echoz/Perch/docs/base.webp

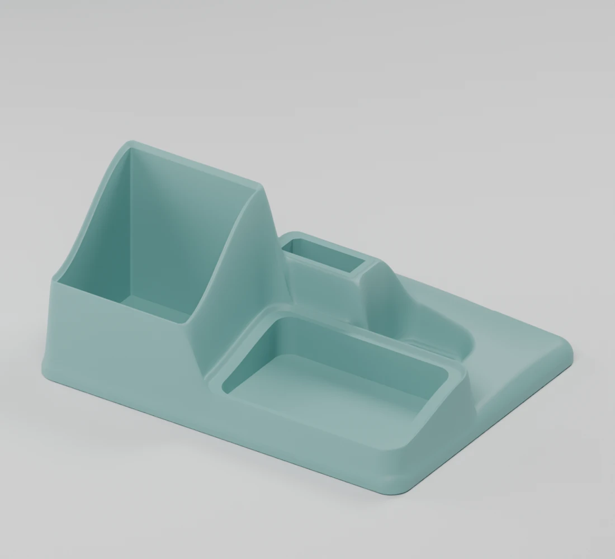
docs/base.webp
