echoz/Perch/docs/dock.webp

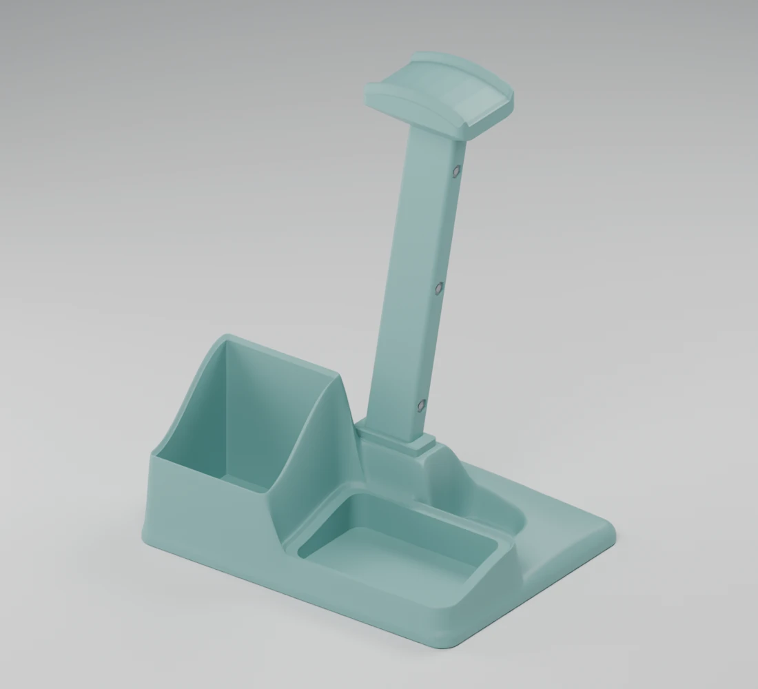
docs/dock.webp
