echoz/Perch/docs/loaded.webp

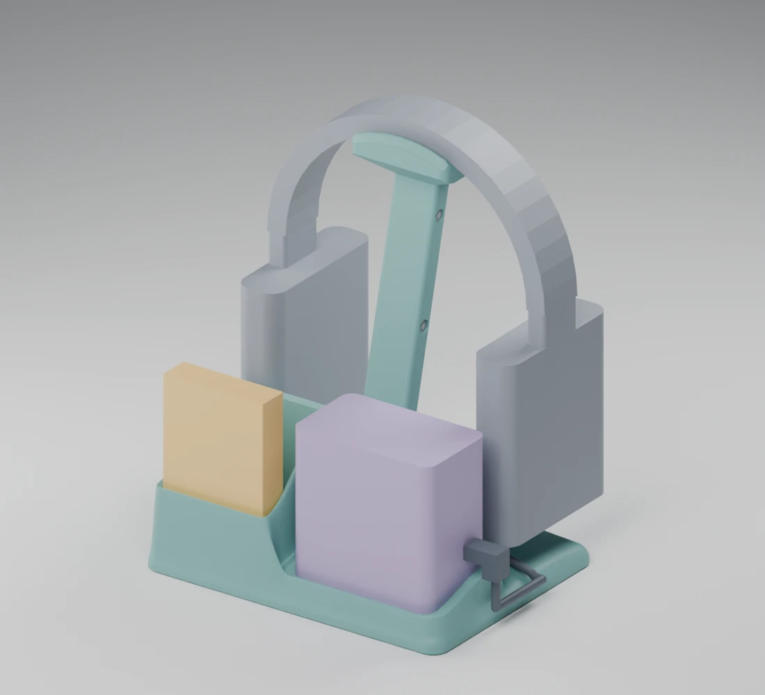
docs/loaded.webp
