echoz/Perch/docs/mast.webp

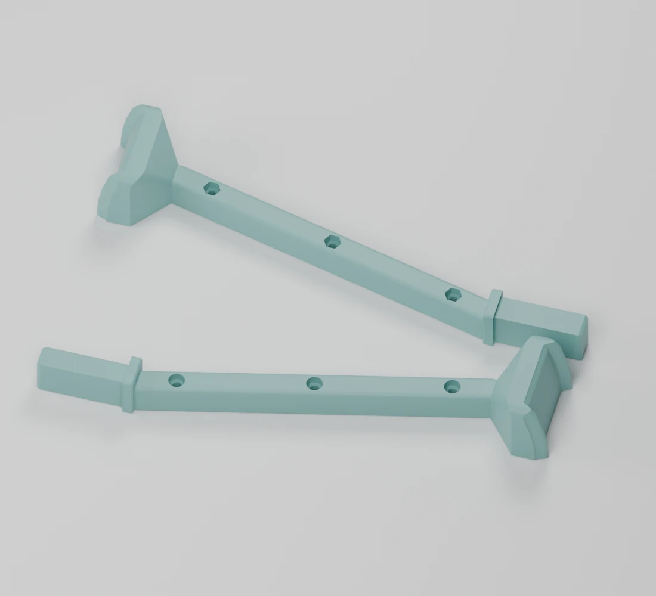
docs/mast.webp
