echoz/Perch/docs/rear.webp

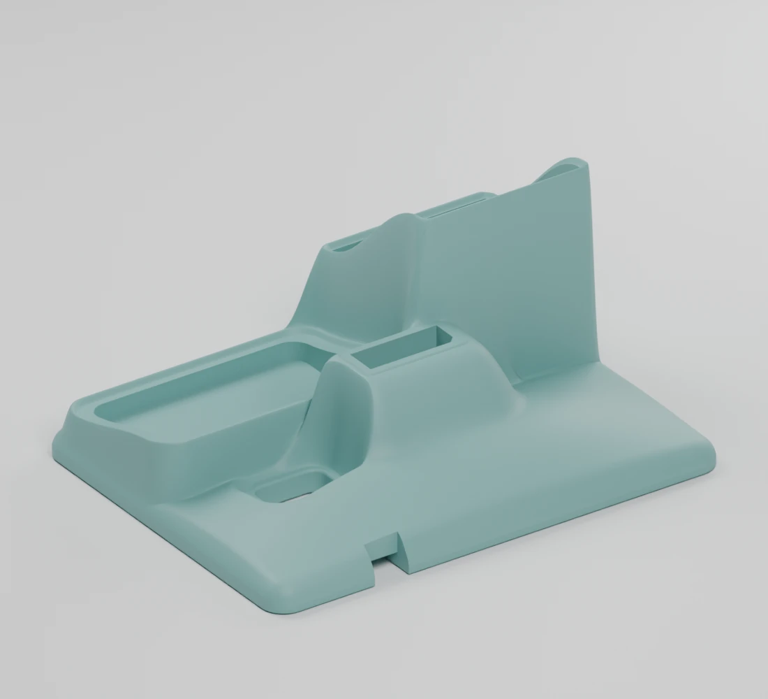
docs/rear.webp
