echoz/Perch/previews/base-cable-route.png

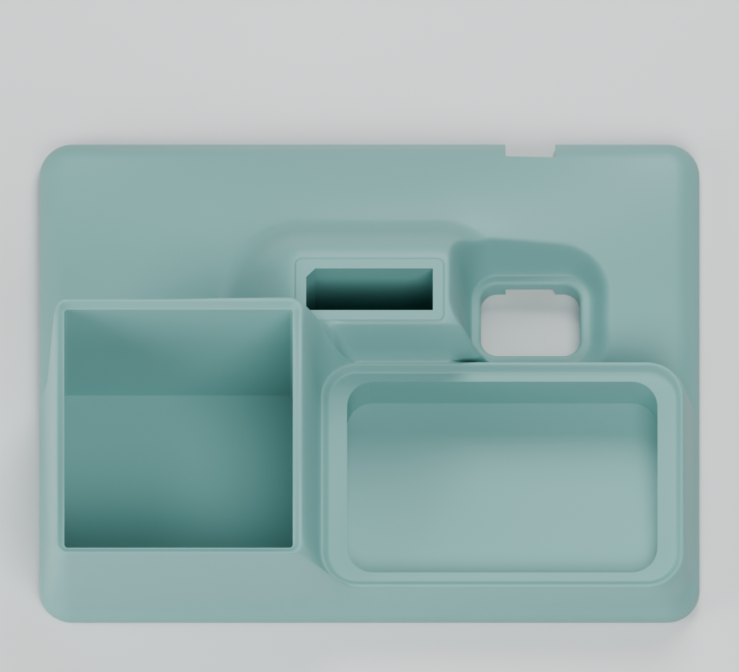
previews/base-cable-route.png
