echoz/Perch/previews/base-rear.png

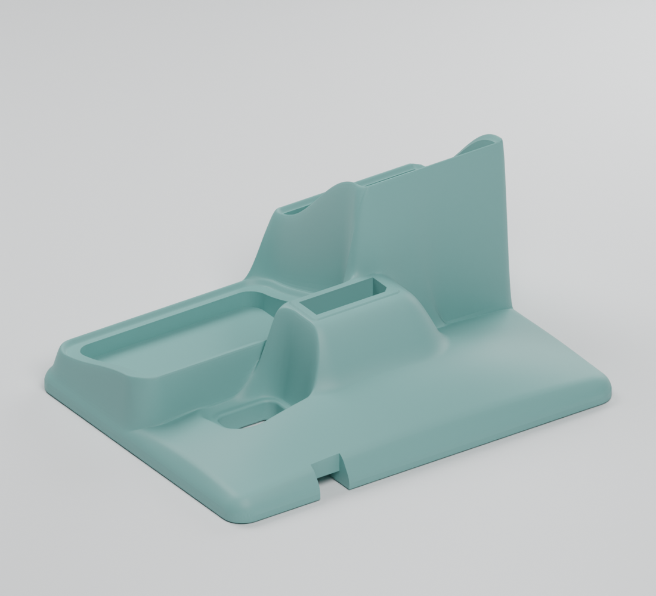
previews/base-rear.png
