echoz/Perch/previews/saddle-detail.png

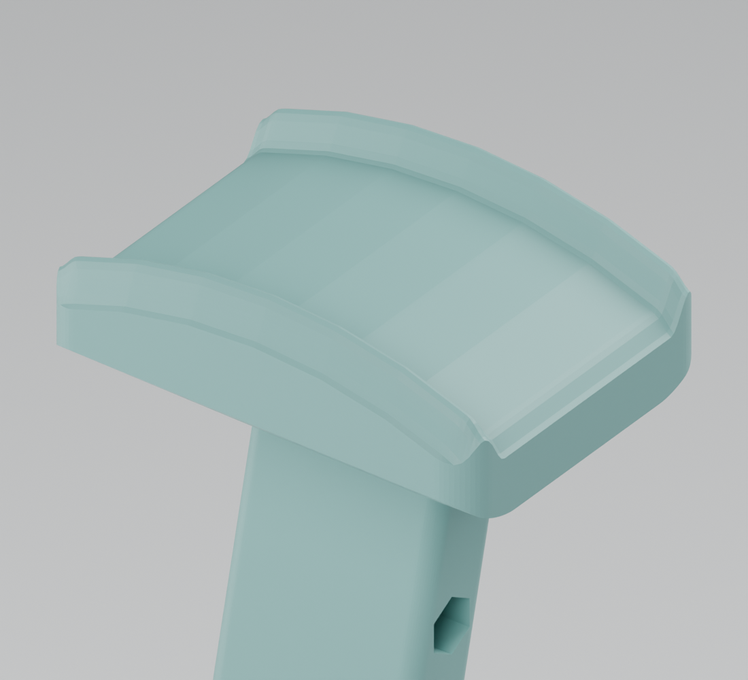
previews/saddle-detail.png
