echoz/Perch/previews/mast-print-layout.png

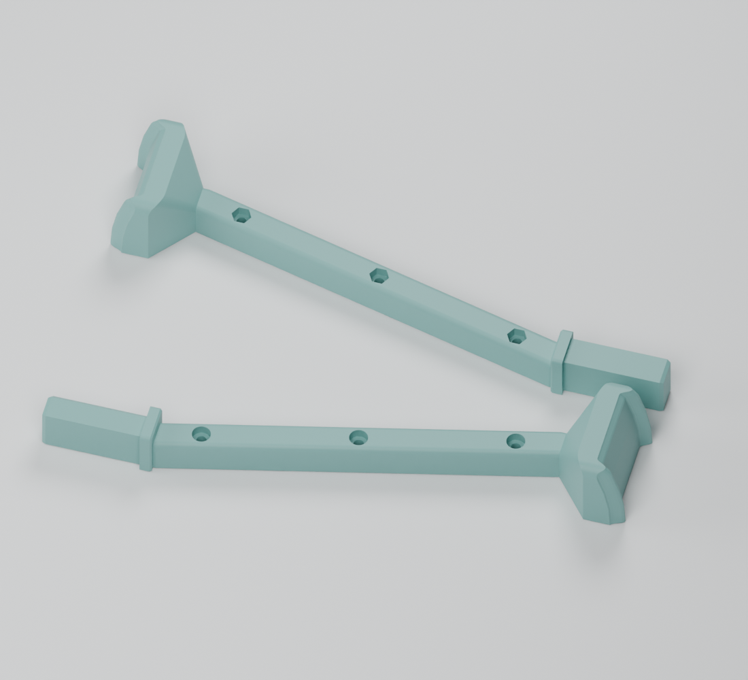
previews/mast-print-layout.png
