echoz/Perch/previews/mast-joint-test.png

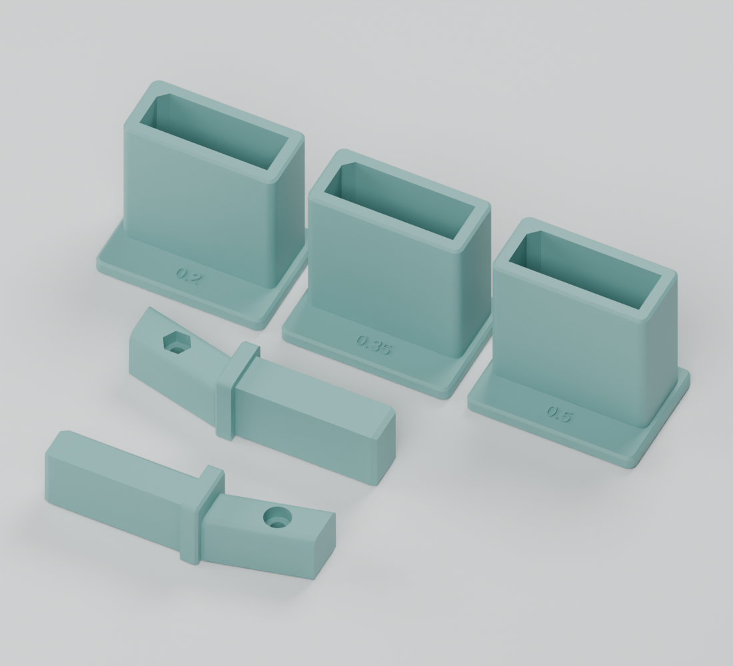
previews/mast-joint-test.png
