echoz/Perch/previews/mini-width-tests.png

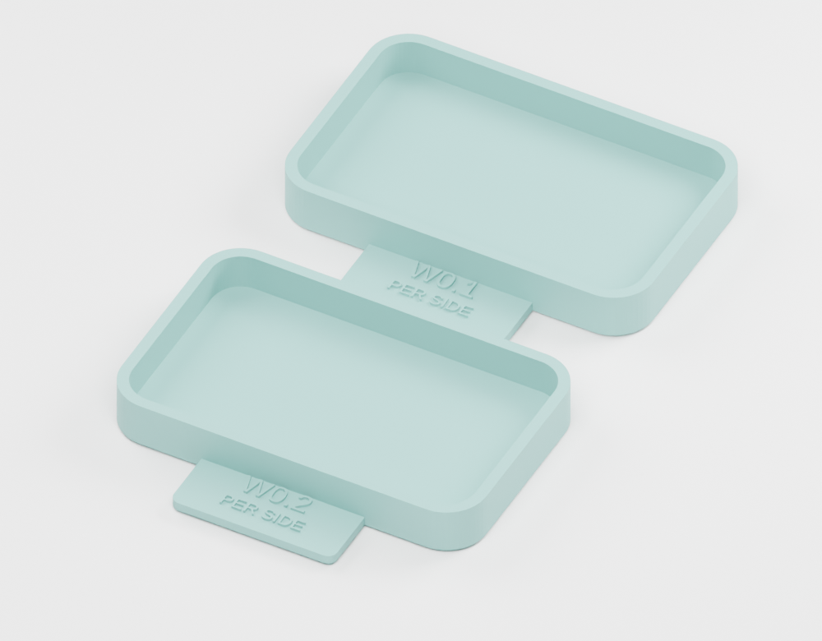
previews/mini-width-tests.png
