echoz/Perch/previews/saddle-test.png

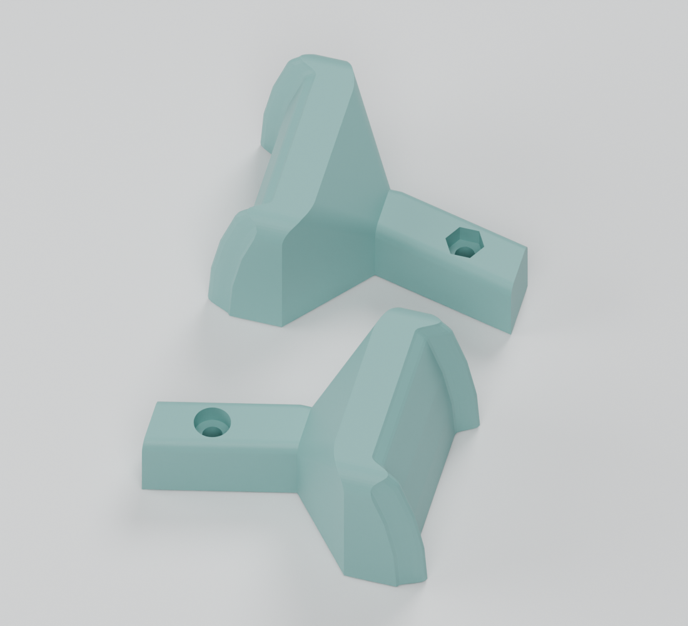
previews/saddle-test.png
