echoz/Perch/(commit log)

2026-10-11 Track Yoto charging station and selected W0.1 fit
    Preserve CAD, fit evidence, build scripts and curated previews. Keep generated print assets, Blender scenes and local files out of Git.
    [compact_dock.scad, mini_width_tests.scad]
2026-10-11 Make the README useful for printing and assembly
    Lead with candidate downloads, print parts and orientation, fasteners and fit status. Preserve the existing Yoto name while naming is under consideration.
2026-10-11 Name the project Perch
    Update the README, CAD guide and repository links for the chosen project name.
2026-10-11 Link Perch’s public project website
2026-10-11 Host Perch’s website in its own repository
    Move the reviewed static showcase into docs for standalone GitHub Pages publishing from main. Keep the print and editable-CAD downloads, actual renders and physical-fit limits. Update website ownership and preview instructions.
    Validation: exact asset comparison with the previously checked page, local asset/ARIA/fragment validation, standalone Safari preview and independent migration review. Geometry is unchanged.
2026-10-11 License Perch designs for noncommercial sharing and remixes
    Apply CC BY-NC-SA 4.0 to the original CAD design, meshes, documentation and renders, with explicit scope and download notices. Preserve published geometry and print archives.
